pvvx/TlsrTools/README.md

# TlsrTools
Alternative programmer for Telink TLSR826x on STM32F103C8T6.

# Telink SWIRE protocol when programming E104-BT10-x modules
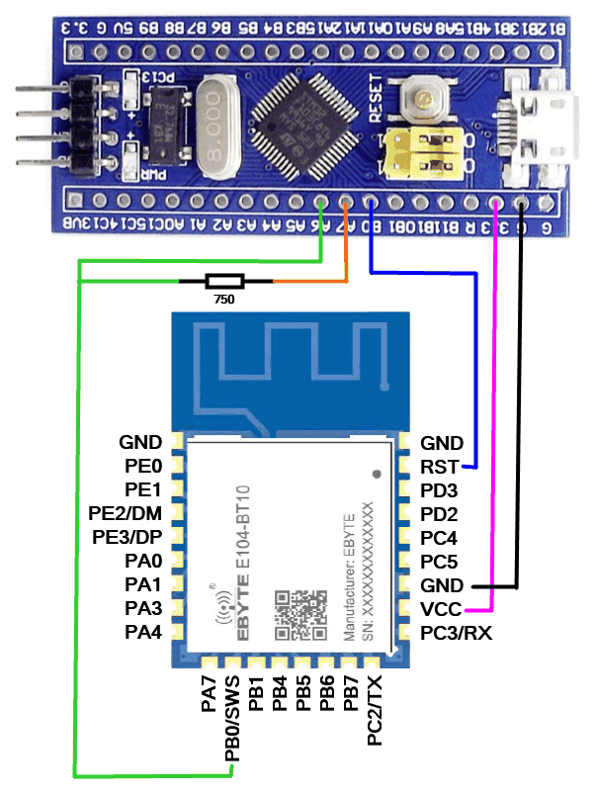
[picture p1: Stm32miniSwireShm.gif]


# Programming JDY-10 Modules...
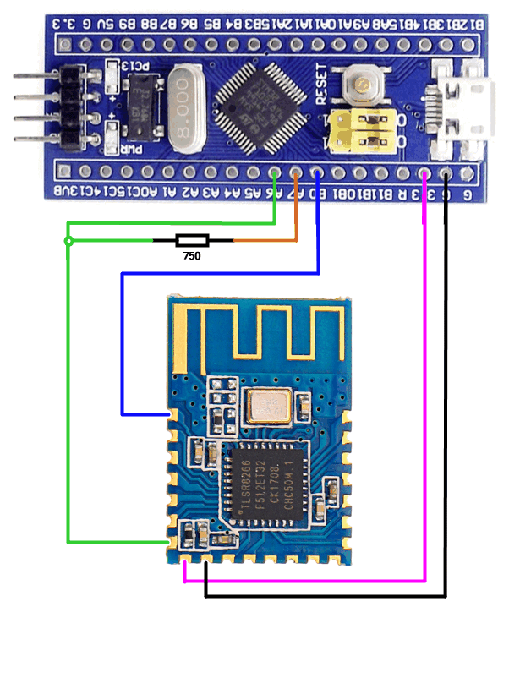
[picture p2: TlsrTool_JDY-10.gif]


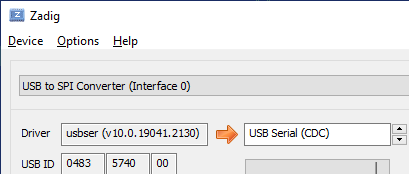
[picture p3: USBCDC.png]


[Документация на русском языке](https://github.com/pvvx/TlsrTools/blob/master/DOCs)

[Прошивка для STM32F103C8T6](https://github.com/pvvx/TlsrTools/blob/master/STM32F103)

[Программа для PC под Windows](https://github.com/pvvx/TlsrTools/blob/master/bin)

[Форум](https://esp8266.ru/forum/threads/programmator-dlja-tlsr.4587)
