pvvx/TlsrTools/(threads)

Thread 1 (2020-10-11):

Wrong USB Driver

Kabron287, 2020-10-11:
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

Kabron287, 2020-10-11:
Tested on Two Bluepills

s-valeriy, 2022-11-13:
[usbd_desc.zip](https://github.com/pvvx/TlsrTools/files/9996962/usbd_desc.zip)
I was able to fix the problem by modifying usbd_desc.c (zip attached)

Thread 3 (2024-05-29):

Can not compile firmware for STM32 - missing project file or Makefile

MKesenheimer, 2024-05-29:
Hello,

I would like to compile the firmware `SWireSTM32` for the `STM32F103`, however a project file or a Makefile is missing in the project. Could you please add your STM32CubeIDE project file or the Makefile for this project?

Thanks,
Matthias
