pvvx/TlsrTools/floader/Include/gpio_default_8267.h

#pragma once


#define GPIO_PULL_UP_0		0
#define GPIO_PULL_UP_1M		1
#define GPIO_PULL_UP_10K	2
#define GPIO_PULL_DN_100K	3


#ifndef PA0_INPUT_ENABLE
#define PA0_INPUT_ENABLE	0
#endif
#ifndef PA1_INPUT_ENABLE
#define PA1_INPUT_ENABLE	0
#endif
#ifndef PA2_INPUT_ENABLE
#define PA2_INPUT_ENABLE	0
#endif
#ifndef PA3_INPUT_ENABLE
#define PA3_INPUT_ENABLE	0
#endif
#ifndef PA4_INPUT_ENABLE
#define PA4_INPUT_ENABLE	0
#endif
#ifndef PA5_INPUT_ENABLE
#define PA5_INPUT_ENABLE	0
#endif
#ifndef PA6_INPUT_ENABLE
#define PA6_INPUT_ENABLE	0
#endif
#ifndef PA7_INPUT_ENABLE
#define PA7_INPUT_ENABLE	0
#endif
#ifndef PA0_OUTPUT_ENABLE
#define PA0_OUTPUT_ENABLE	0
#endif
#ifndef PA1_OUTPUT_ENABLE
#define PA1_OUTPUT_ENABLE	0
#endif
#ifndef PA2_OUTPUT_ENABLE
#define PA2_OUTPUT_ENABLE	0
#endif
#ifndef PA3_OUTPUT_ENABLE
#define PA3_OUTPUT_ENABLE	0
#endif
#ifndef PA4_OUTPUT_ENABLE
#define PA4_OUTPUT_ENABLE	0
#endif
#ifndef PA5_OUTPUT_ENABLE
#define PA5_OUTPUT_ENABLE	0
#endif
#ifndef PA6_OUTPUT_ENABLE
#define PA6_OUTPUT_ENABLE	0
#endif
#ifndef PA7_OUTPUT_ENABLE
#define PA7_OUTPUT_ENABLE	0
#endif
#ifndef PA0_DATA_STRENGTH
#define PA0_DATA_STRENGTH	1
#endif
#ifndef PA1_DATA_STRENGTH
#define PA1_DATA_STRENGTH	1
#endif
#ifndef PA2_DATA_STRENGTH
#define PA2_DATA_STRENGTH	1
#endif
#ifndef PA3_DATA_STRENGTH
#define PA3_DATA_STRENGTH	1
#endif
#ifndef PA4_DATA_STRENGTH
#define PA4_DATA_STRENGTH	1
#endif
#ifndef PA5_DATA_STRENGTH
#define PA5_DATA_STRENGTH	1
#endif
#ifndef PA6_DATA_STRENGTH
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
#define PULL_WAKEUP_SRC_PE3	0
#endif
#ifndef PULL_WAKEUP_SRC_PE4
#define PULL_WAKEUP_SRC_PE4	0
#endif
#ifndef PULL_WAKEUP_SRC_PE5
#define PULL_WAKEUP_SRC_PE5	0
#endif
#ifndef PULL_WAKEUP_SRC_PE6
#define PULL_WAKEUP_SRC_PE6	0
#endif
#ifndef PULL_WAKEUP_SRC_PE7
#define PULL_WAKEUP_SRC_PE7	0
#endif


//////////////////////////////////////////////////
#ifndef PF0_INPUT_ENABLE
#define PF0_INPUT_ENABLE	0
#endif
#ifndef PF1_INPUT_ENABLE
#define PF1_INPUT_ENABLE	0
#endif
#ifndef PF0_OUTPUT_ENABLE
#define PF0_OUTPUT_ENABLE	0
#endif
#ifndef PF1_OUTPUT_ENABLE
#define PF1_OUTPUT_ENABLE	0
#endif
#ifndef PF0_DATA_STRENGTH
#define PF0_DATA_STRENGTH	1
#endif
#ifndef PF1_DATA_STRENGTH
#define PF1_DATA_STRENGTH	1
#endif
#ifndef PF0_DATA_OUT
#define PF0_DATA_OUT	0
#endif
#ifndef PF1_DATA_OUT
#define PF1_DATA_OUT	0
#endif
#ifndef PF0_FUNC
#define PF0_FUNC	AS_GPIO
#endif
#ifndef PF1_FUNC
#define PF1_FUNC	AS_GPIO
#endif
#ifndef PULL_WAKEUP_SRC_PF0
#define PULL_WAKEUP_SRC_PF0	0
#endif
#ifndef PULL_WAKEUP_SRC_PF1
#define PULL_WAKEUP_SRC_PF1	0
#endif


#define	PM_PIN_PULLUP_1M		1
#define	PM_PIN_PULLUP_10K		2
#define	PM_PIN_PULLDOWN_100K	3
#define	PM_PIN_UP_DOWN_FLOAT	0
