pvvx/TlsrTools/SWireSTM32/Src/main.c

/**
  ******************************************************************************
  * @file    USB_Device/CDC_Standalone/Src/main.c
  * @author  MCD Application Team
  * @version V1.4.0
  * @date    29-April-2016
  * @brief   USB device CDC application main file.
  ******************************************************************************
  * @attention
  *
  * <h2><center>&copy; Copyright © 2016 STMicroelectronics International N.V.
  * All rights reserved.</center></h2>
  *
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
  ******************************************************************************
  */

/* Includes ------------------------------------------------------------------*/
#include "main.h"


/** @addtogroup STM32F1xx_HAL_Validation
  * @{
  */

/** @addtogroup STANDARD_CHECK
  * @{
  */

/* Private typedef -----------------------------------------------------------*/
/* Private define ------------------------------------------------------------*/
/* Private macro -------------------------------------------------------------*/
/* Private variables ---------------------------------------------------------*/
USBD_HandleTypeDef USBD_Device;

/* Private function prototypes -----------------------------------------------*/
void SystemClock_Config(void);

/* Private functions ---------------------------------------------------------*/

/**
  * @brief  Main program.
  * @param  None
  * @retval None
  */

void MX_GPIO_Init(void)
{

  GPIO_InitTypeDef GPIO_InitStruct;

  /* GPIO Ports Clock Enable */
  __HAL_RCC_GPIOA_CLK_ENABLE();	
  __HAL_RCC_GPIOC_CLK_ENABLE();
  __HAL_RCC_GPIOB_CLK_ENABLE();

  /*Configure GPIO pin Output Level */
  HAL_GPIO_WritePin(GPIOC, GPIO_PIN_13, GPIO_PIN_RESET);
  HAL_GPIO_WritePin(GPIOB, GPIO_PIN_0, GPIO_PIN_SET);

  /*Configure GPIO pin : PC13 - LED */
  GPIO_InitStruct.Pin = GPIO_PIN_13;
  GPIO_InitStruct.Mode = GPIO_MODE_OUTPUT_PP;
  GPIO_InitStruct.Speed = GPIO_SPEED_FREQ_MEDIUM; // GPIO_SPEED_FREQ_LOW;
  HAL_GPIO_Init(GPIOC, &GPIO_InitStruct);
	
  /* конфигурация вывода PB0 на выход c OK на RST модуля */
  GPIO_InitStruct.Pin = GPIO_PIN_0; // номер вывода
  GPIO_InitStruct.Mode = GPIO_MODE_OUTPUT_OD; // режим выхода
  GPIO_InitStruct.Speed = GPIO_SPEED_FREQ_MEDIUM; // средняя скорость выхода
  HAL_GPIO_Init(GPIOB, &GPIO_InitStruct);
  HAL_GPIO_WritePin(GPIOB, GPIO_PIN_0, GPIO_PIN_SET);

}

int main(void)
{
  /* Reset of all peripherals, Initializes the Flash interface and the Systick. */
  HAL_Init();

  /* Configure the system clock to 72 MHz */
  SystemClock_Config();
  MX_GPIO_Init();
  //  /* Initialize LEDs */
  HAL_GPIO_TogglePin(GPIOC, GPIO_PIN_13);

  /* Init Device Library */
  USBD_Init(&USBD_Device, &VCP_Desc, 0);

  /* Add Supported Class */
  USBD_RegisterClass(&USBD_Device, USBD_CDC_CLASS);

  /* Add CDC Interface Class */
  USBD_CDC_RegisterInterface(&USBD_Device, &USBD_CDC_fops);

  /* Start Device Process */
  USBD_Start(&USBD_Device);

  /* Infinite loop */
  while (1)
  {
  }
}

/**
  * @brief  System Clock Configuration
  *         The system Clock is configured as follow :
  *            System Clock source            = PLL (HSE)
  *            SYSCLK(Hz)                     = 72000000
  *            HCLK(Hz)                       = 72000000
  *            AHB Prescaler                  = 1
  *            APB1 Prescaler                 = 2
  *            APB2 Prescaler                 = 1
  *            HSE Frequency(Hz)              = 8000000
  *            HSE PREDIV1                    = 1
  *            PLLMUL                         = 9
  *            Flash Latency(WS)              = 2
  * @param  None
  * @retval None
  */
void SystemClock_Config(void)
{
  RCC_ClkInitTypeDef clkinitstruct = {0};
  RCC_OscInitTypeDef oscinitstruct = {0};
  RCC_PeriphCLKInitTypeDef rccperiphclkinit = {0};

  /* Enable HSE Oscillator and activate PLL with HSE as source */
  oscinitstruct.OscillatorType  = RCC_OSCILLATORTYPE_HSE;
  oscinitstruct.HSEState        = RCC_HSE_ON;
  oscinitstruct.HSEPredivValue  = RCC_HSE_PREDIV_DIV1;
  oscinitstruct.PLL.PLLMUL      = RCC_PLL_MUL9;

  oscinitstruct.PLL.PLLState    = RCC_PLL_ON;
  oscinitstruct.PLL.PLLSource   = RCC_PLLSOURCE_HSE;

  if (HAL_RCC_OscConfig(&oscinitstruct)!= HAL_OK)
  {
    /* Start Conversation Error */
    Error_Handler();
  }

  /* USB clock selection */
  rccperiphclkinit.PeriphClockSelection = RCC_PERIPHCLK_USB;
  rccperiphclkinit.UsbClockSelection = RCC_USBCLKSOURCE_PLL_DIV1_5;
  HAL_RCCEx_PeriphCLKConfig(&rccperiphclkinit);

  /* Select PLL as system clock source and configure the HCLK, PCLK1 and PCLK2
  clocks dividers */
  clkinitstruct.ClockType = (RCC_CLOCKTYPE_SYSCLK | RCC_CLOCKTYPE_HCLK | RCC_CLOCKTYPE_PCLK1 | RCC_CLOCKTYPE_PCLK2);
  clkinitstruct.SYSCLKSource = RCC_SYSCLKSOURCE_PLLCLK;
  clkinitstruct.AHBCLKDivider = RCC_SYSCLK_DIV1;
  clkinitstruct.APB1CLKDivider = RCC_HCLK_DIV2;
  clkinitstruct.APB2CLKDivider = RCC_HCLK_DIV1;
  if (HAL_RCC_ClockConfig(&clkinitstruct, FLASH_LATENCY_2)!= HAL_OK)
  {
    /* Start Conversation Error */
    Error_Handler();
  }
}

/**
  * @brief  This function is executed in case of error occurrence.
  * @param  None
  * @retval None
  */
void Error_Handler(void)
{
  /* Turn LED3 on */
//  BSP_LED_On(LED3);
  while (1)
  {
	  HAL_GPIO_TogglePin(GPIOC, GPIO_PIN_13);
  }
}

/**
  * @brief  Toggle LEDs to shows user input state.
  * @param  None
  * @retval None
  */
void Toggle_Leds(void)
{
//  static uint32_t ticks;

//  if (ticks++ == 2)
//  {
	  HAL_GPIO_TogglePin(GPIOC, GPIO_PIN_13);
//	  ticks = 0;
//  }
}

#ifdef  USE_FULL_ASSERT

/**
  * @brief  Reports the name of the source file and the source line number
  *         where the assert_param error has occurred.
  * @param  file: pointer to the source file name
  * @param  line: assert_param error line source number
  * @retval None
  */
void assert_failed(uint8_t* file, uint32_t line)
{
  /* User can add his own implementation to report the file name and line number,
     ex: printf("Wrong parameters value: file %s on line %d\r\n", file, line) */

  /* Infinite loop */
  while (1)
  {
	  HAL_GPIO_TogglePin(GPIOC, GPIO_PIN_13);
  }
}

#endif

/**
  * @}
  */

/**
  * @}
  */

/************************ (C) COPYRIGHT STMicroelectronics *****END OF FILE****/
