pvvx/TlsrTools/floader/Source/sleep.c

#include "common.h"

/**
 * @brief     This function performs to gets system timer0 address.
 * @param[in] none.
 * @return    timer0 address.
 */

static inline unsigned long clock_time(void)
{
	return reg_system_tick;
}

/**
 * @brief     This function performs to calculation exceed us of the timer.
 * @param[in] ref - Variable of reference timer address.
 * @param[in] span_us - Variable of span us.
 * @return    the exceed.
 */

static inline unsigned int clock_time_exceed(unsigned int ref, unsigned int us)
{
	return ((unsigned int)(clock_time() - ref) > us * 16);
}

_attribute_ram_code_ void sleep_us (u32 us)
{
	u32 t = clock_time();
	while(!clock_time_exceed(t, us)){
	}
}
