pvvx/TlsrTools/(commit log)

2019-12-04 ver 0.0.1.3
    [TlsrTool.cfg]
2020-12-28 Fw STM32F103 v0006, TlsrTool v0.0.1.5
